goodrobotics/wifistepper/documentation/src/index.md

---
layout: default
title: Home
nav_order: 1
description: "Wi-Fi Stepper Project Documentation by Good Robotics"
---
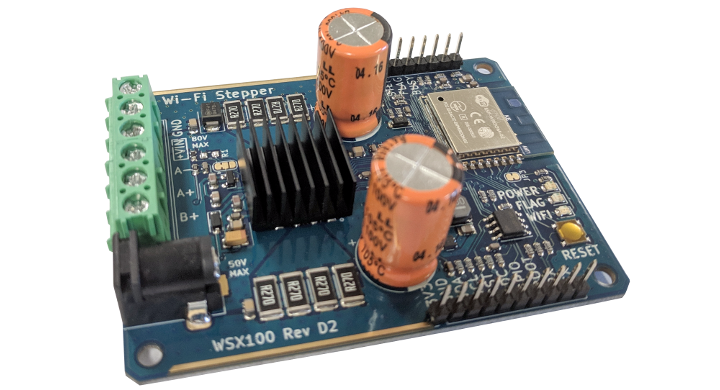
[picture p2: documentation/src/images/splash.png]

# Wi-Fi Stepper
{: .text-center .fs-9 .mb-1 }

## Project Documentation
{: .text-center .fs-7 .mb-6 .mt-1 }

An easy-to-use stepper motor controller accessible over wifi that can handle small to big stepper motors with input voltages ranging from 12V to 80V and output current up to 10A.
{: .fs-6 .fw-300 }

[Get started now](/getting-started.html){: .btn .btn-primary .fs-5 .mb-4 .mb-md-0 .mr-2 } [View it on GitHub](https://github.com/goodrobotics/wifistepper){: .btn .fs-5 .mb-4 .mb-md-0 }

---
