goodrobotics/wifistepper/documentation/src/interfaces/index.md

---
layout: default
title: Interfaces
nav_order: 8
has_children: true
---
# Interfaces

The following interfaces can be used to control the Wi-Fi Stepper programtically. To learn about the available commands, visit the [commands section](/commands/index.html).
