goodrobotics/wifistepper/hardware/wsx100/screenshot.png

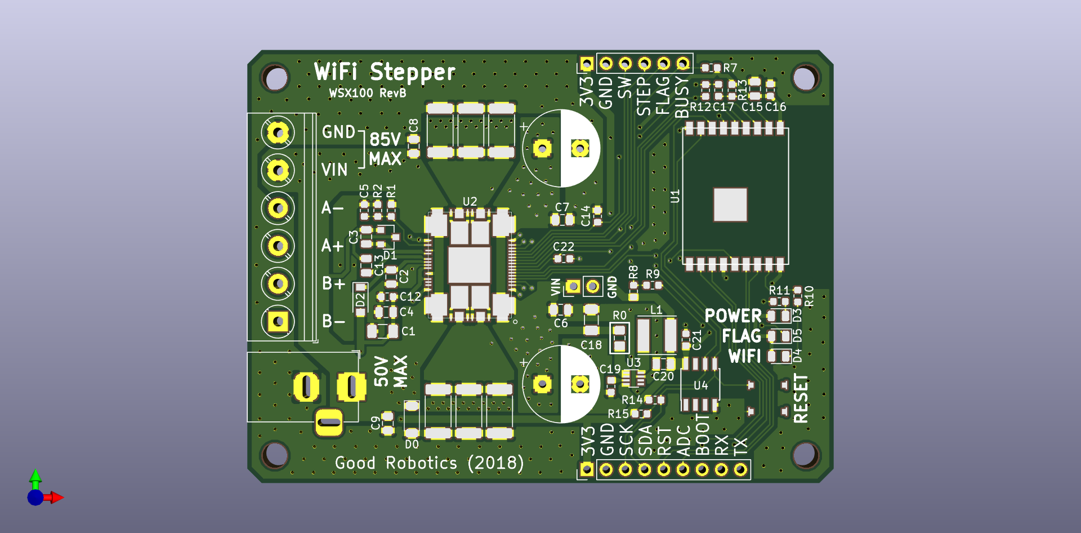
hardware/wsx100/screenshot.png
