goodrobotics/wifistepper/documentation/src/getting-started.md

---
layout: default
title: Getting Started
nav_order: 2
---
# Getting started with the Wi-Fi Stepper

The following tutorial video is a quick intrduction to get you started using the browser-based quick start guide.

<iframe width="560" height="315" src="https://www.youtube-nocookie.com/embed/1BNP5NVybpc" frameborder="0" allow="accelerometer; autoplay; encrypted-media; gyroscope; picture-in-picture" allowfullscreen></iframe>

# Settings Page Overview

An overview of the difference configuration settings of the Wi-Fi Stepper

<iframe width="560" height="315" src="https://www.youtube-nocookie.com/embed/98ZXk8F2e30" frameborder="0" allow="accelerometer; autoplay; encrypted-media; gyroscope; picture-in-picture" allowfullscreen></iframe>
