goodrobotics/wifistepper/hardware/powerstep01-breakout/powerstep01-breakout.pdf

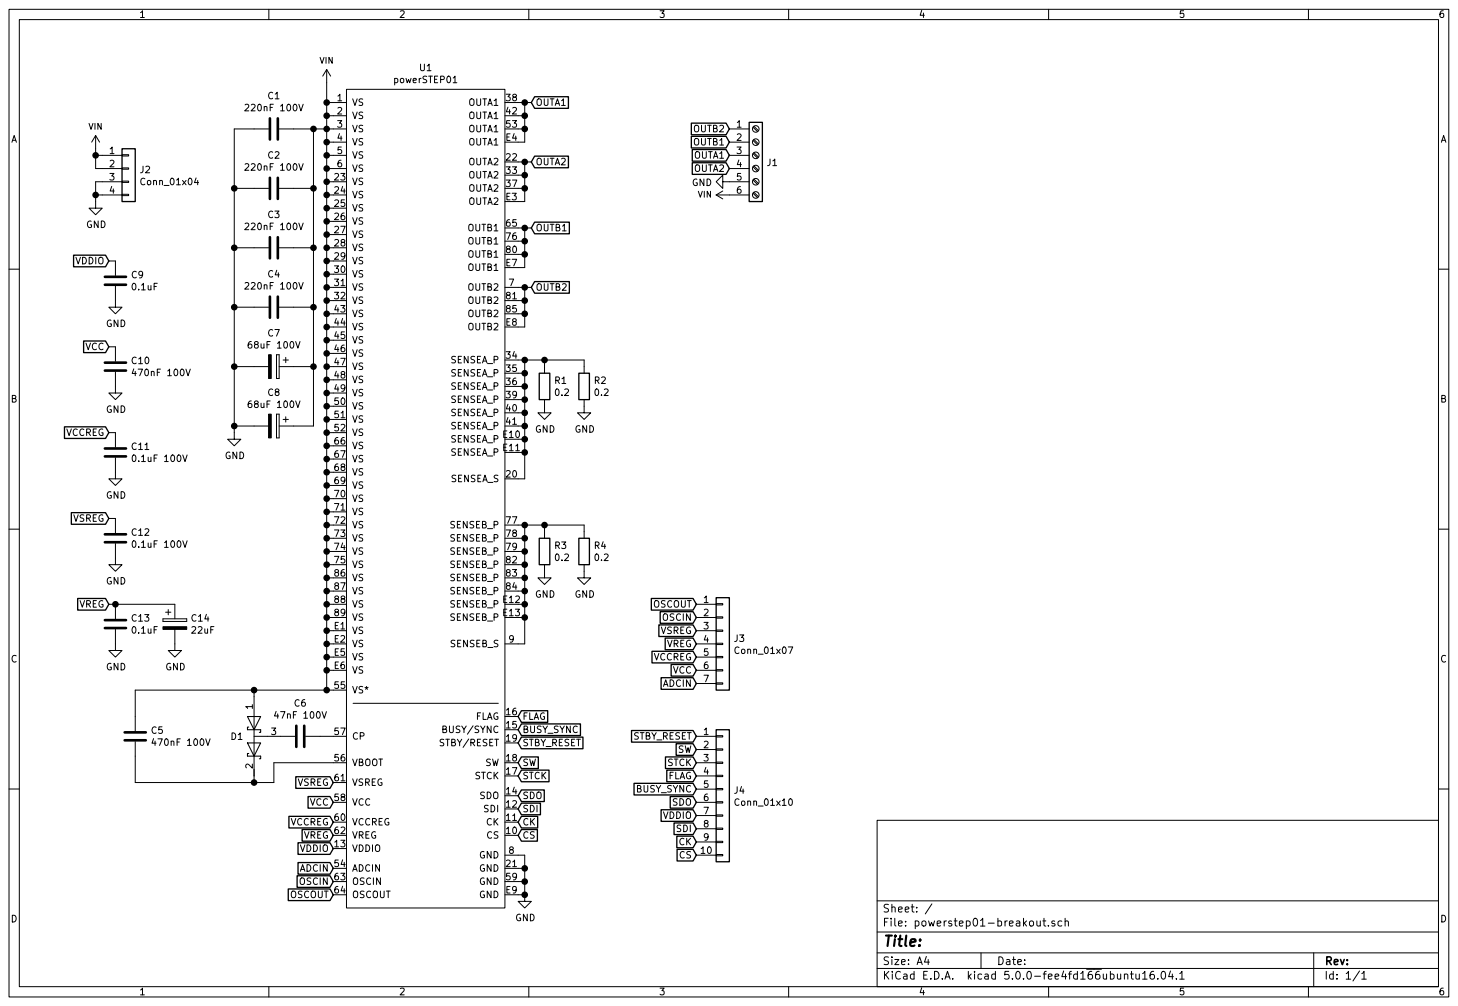
[picture p6: page 1]

File: powerstep01-breakout.sch Sheet: /
