goodrobotics/wifistepper/hardware/wsx100/wifistepper.pdf

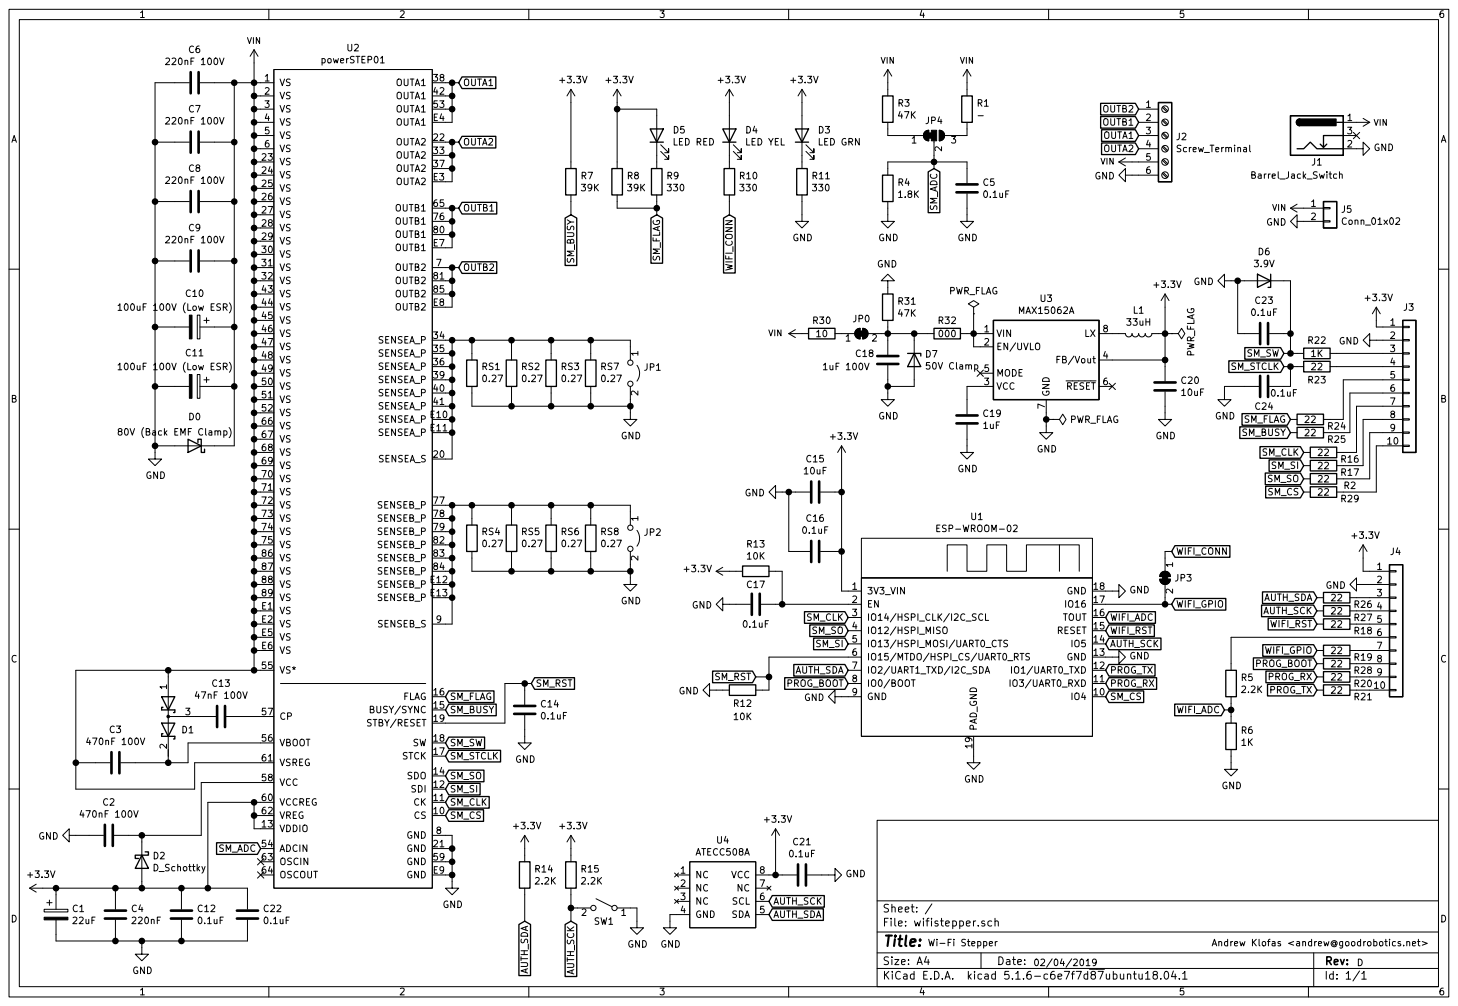
[picture p7: page 1]

File: wifistepper.sch Sheet: / RS5
