goodrobotics/wifistepper/hardware/wsx100/wifistepper.kicad_pcb

## KiCad design hardware/wsx100/wifistepper.kicad_pcb (2021-05-19)

Schematic: wifistepper.sch

Parts:
C1: 22uF; C_1206_3216Metric
C2, C3: 470nF 100V; C_0805_2012Metric
C4: 220nF; C_0805_2012Metric
C5, C12, C14, C16, C17, C21, C22, C23, C24: 0.1uF; C_0603_1608Metric
C6, C7, C8, C9: 220nF 100V; C_0805_2012Metric
C10, C11: 100uF 100V (Low ESR); CP_Radial_D12.5mm_P5.00mm
C13: 47nF 100V; C_0805_2012Metric
C15, C20: 10uF; C_0805_2012Metric
C18: 1uF 100V; C_0805_2012Metric
C19: 1uF; C_0603_1608Metric
D0: 80V (Back EMF Clamp); D_SMB
D1: D_Schottky_x2_Serial_AKC; SOT-23
D2: D_Schottky; D_SOD-123
D3: LED GRN; D_0805_2012Metric
D4: LED YEL; D_0805_2012Metric
D5: LED RED; D_0805_2012Metric
D6: 3.9V; D_SOD-123
D7: 50V Clamp; D_SMF_DO-219AB
FB1: Ferrite_Bead_Small; L_0603_1608Metric
J1: Barrel_Jack_Switch; BarrelJack_Horizontal
J2: Screw_Terminal; TerminalBlock_Phoenix_PT-1,5-6-5.0-H_1x06_P5.00mm_Horizontal
J3, J4: Conn_01x10; PinHeader_1x10_P2.54mm_Vertical
J5: Conn_01x02; PinHeader_1x02_P2.54mm_Vertical
JP0, JP3: SolderJumper_2_Bridged; SolderJumper-2_P1.3mm_Bridged_RoundedPad1.0x1.5mm
JP1, JP2: Jumper_2_Open; STpowerSTEP01_JMP
JP4: SolderJumper_3_Bridged12; SolderJumper-3_P1.3mm_Bridged12_RoundedPad1.0x1.5mm
L1: 33uH; L_Taiyo-Yuden_NR-50xx
R1: -; Resistor_NP_0805
R2, R16, R17, R18, R19, R20, R21, R23, R24, R25, R26, R27, R28, R29: 22; R_0603_1608Metric
R3: 47K; R_0603_1608Metric
R4: 1.8K; R_0603_1608Metric
R5, R14, R15: 2.2K; R_0603_1608Metric
R6, R22: 1K; R_0603_1608Metric
R7, R8: 39K; R_0603_1608Metric
R9, R10, R11: 330; R_0603_1608Metric
R12, R13: 10K; R_0603_1608Metric
RS1, RS2, RS3, RS4, RS5, RS6, RS7, RS8: 0.27; R_2512_6332Metric
SW1: SW_SPST; TL3315NF100Q
U1: ESP-WROOM-02
U2: powerSTEP01
U3: MAX15062A; DFN-8_2x2mm_P0.5mm
U4: ATECC508A; SOIC-8_3.9x4.9mm_P1.27mm

Connections:
+3V3: C1.1, C4.1, C12.1, C15.1, C16.1, C20.1, C21.2, C22.1, D2.2 (A), D3.2 (A), D4.2 (A), D5.2 (A), J3.1, J4.1, L1.1, R7.1, R8.1, R13.2, R14.1, R15.1, U1.1, U2.13, U2.60, U2.62, U3.4 (FB/Vout), U4.8
AUTH_SCK: R15.2, R27.2, SW1.2 (B), U1.14, U4.6
AUTH_SDA: R14.2, R26.2, U1.7, U4.5
GND: C1.2, C2.2, C4.2, C5.2, C6.2, C7.2, C8.2, C9.2, C10.2, C11.2, C12.2, C14.2, C15.2, C16.2, C17.2, C18.2, C19.2, C20.2, C21.1, C22.2, C23.2, C24.2, D0.2 (A), D6.2 (A), D7.2 (A), J1.2, J2.6, J3.2, J4.2, J5.2, JP1.2 (B), JP2.2 (B), R4.2, R6.2, R11.2, R12.2, RS1.1, RS2.1, RS3.1, RS4.1, RS5.1, RS6.1, RS7.1, RS8.1, SW1.1 (A), U1.9, U1.13, U1.18, U1.19, U2.8, U2.21, U2.59, U2.E9, U3.7 (GND), U4.4; also elsewhere on the board
unnamed: C2.1, D2.1 (K), U2.58
unnamed: C3.1, D1.2 (K), U2.56
unnamed: C13.1, U2.57
unnamed: C13.2, D1.3 (common)
unnamed: C17.1, R13.1, U1.2
unnamed: C19.1, U3.3 (VCC)
unnamed: D3.1 (K), R11.1
unnamed: D4.1 (K), R10.1
unnamed: D5.1 (K), R9.1
unnamed: J3.3, R22.1
unnamed: J3.4, R23.1
unnamed: J3.5, R24.1
unnamed: J3.6, R25.1
unnamed: J3.7, R16.1
unnamed: J3.8, R17.1
unnamed: J3.9, R2.1
unnamed: J3.10, R29.1
unnamed: J4.3, R26.1
unnamed: J4.4, R27.1
unnamed: J4.5, R18.1
unnamed: J4.6, R5.1
unnamed: J4.7, R19.1
unnamed: J4.8, R28.1
unnamed: J4.9, R20.1
unnamed: J4.10, R21.1
unnamed 30: JP0.1 (A); also elsewhere on the board
unnamed: JP1.1 (A), RS1.2, RS2.2, RS3.2, RS7.2, U2.20, U2.E10, U2.E11
unnamed: JP2.1 (A), RS4.2, RS5.2, RS6.2, RS8.2, U2.9, U2.E12, U2.E13
unnamed: JP4.1 (A), R3.2
unnamed: JP4.3 (B), R1.2
unnamed: L1.2, U3.8 (LX)
OUTA1: J2.3, U2.38, U2.42, U2.53, U2.E4
OUTA2: J2.4, U2.22, U2.33, U2.37, U2.E3
OUTB1: J2.2, U2.65, U2.76, U2.80, U2.E7
OUTB2: J2.1, U2.7, U2.81, U2.85, U2.E8
PROG_BOOT: R28.2, U1.8
PROG_RX: R20.2, U1.11
PROG_TX: R21.2, U1.12
SM_ADC: C5.1, JP4.2 (C), R4.1, U2.54
SM_BUSY: R7.2, R25.2, U2.15
SM_CLK: R16.2, U1.3, U2.11
SM_CS: R29.2, U1.10, U2.10
SM_FLAG: R8.2, R9.2, R24.2, U2.16
SM_RST: C14.1, R12.1, U1.6, U2.19
SM_SI: R17.2, U1.5, U2.12
SM_SO: R2.2, U1.4, U2.14
SM_STCLK: C24.1, R23.2, U2.17
SM_SW: C23.1, D6.1 (K), R22.2, U2.18
WIFI_ADC: R5.2, R6.1, U1.16
WIFI_CONN: JP3.1 (A), R10.2
WIFI_GPIO: JP3.2 (B), R19.2, U1.17
WIFI_RST: R18.2, U1.15

Notes on the sheet:
Wi-Fi Stepper
Andrew Klofas <andrew@goodrobotics.net>
02/04/2019

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
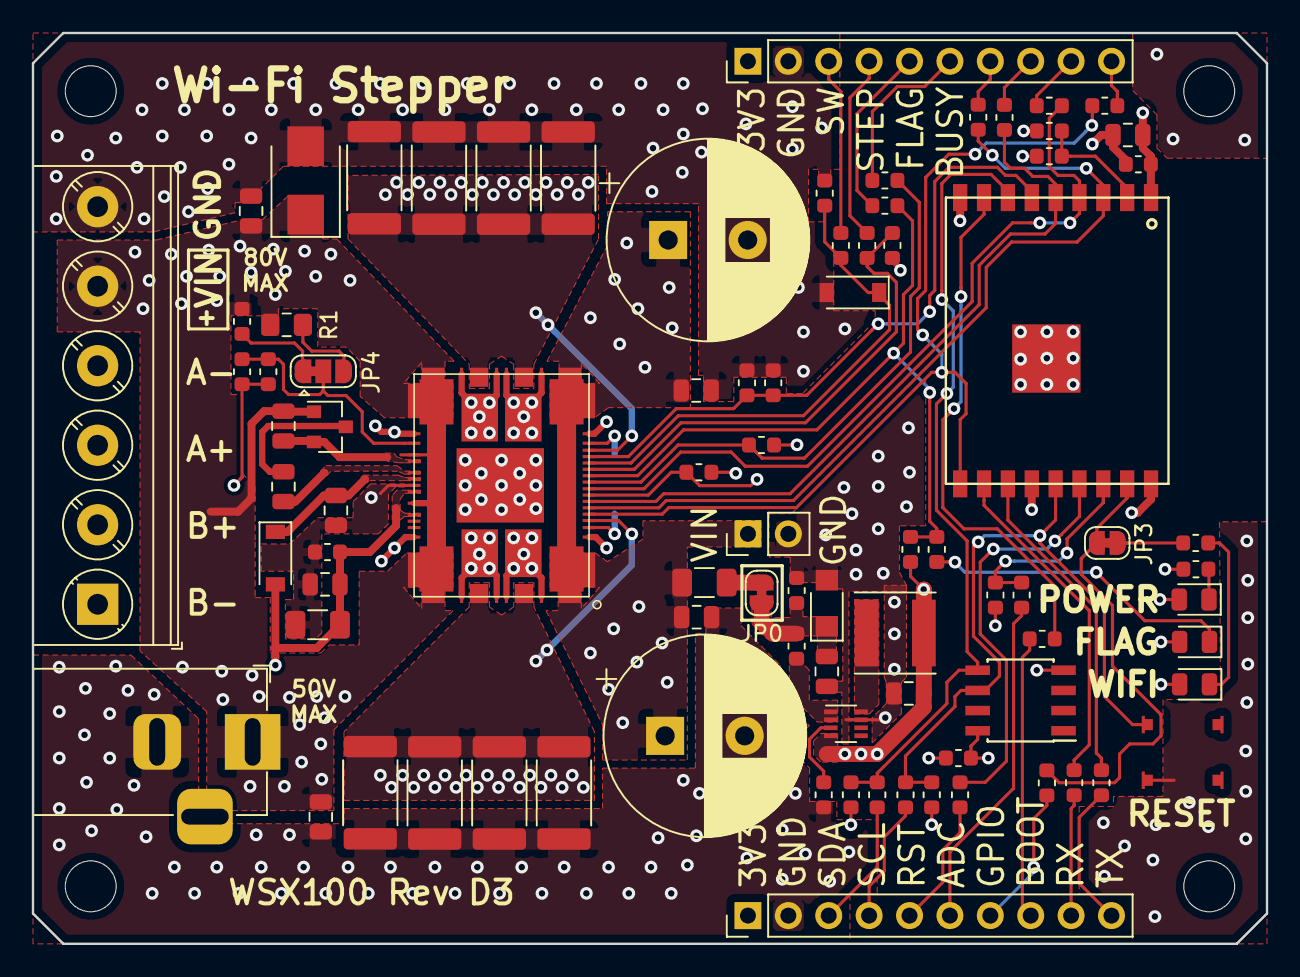
[picture p8: board wifistepper.kicad_pcb from above]

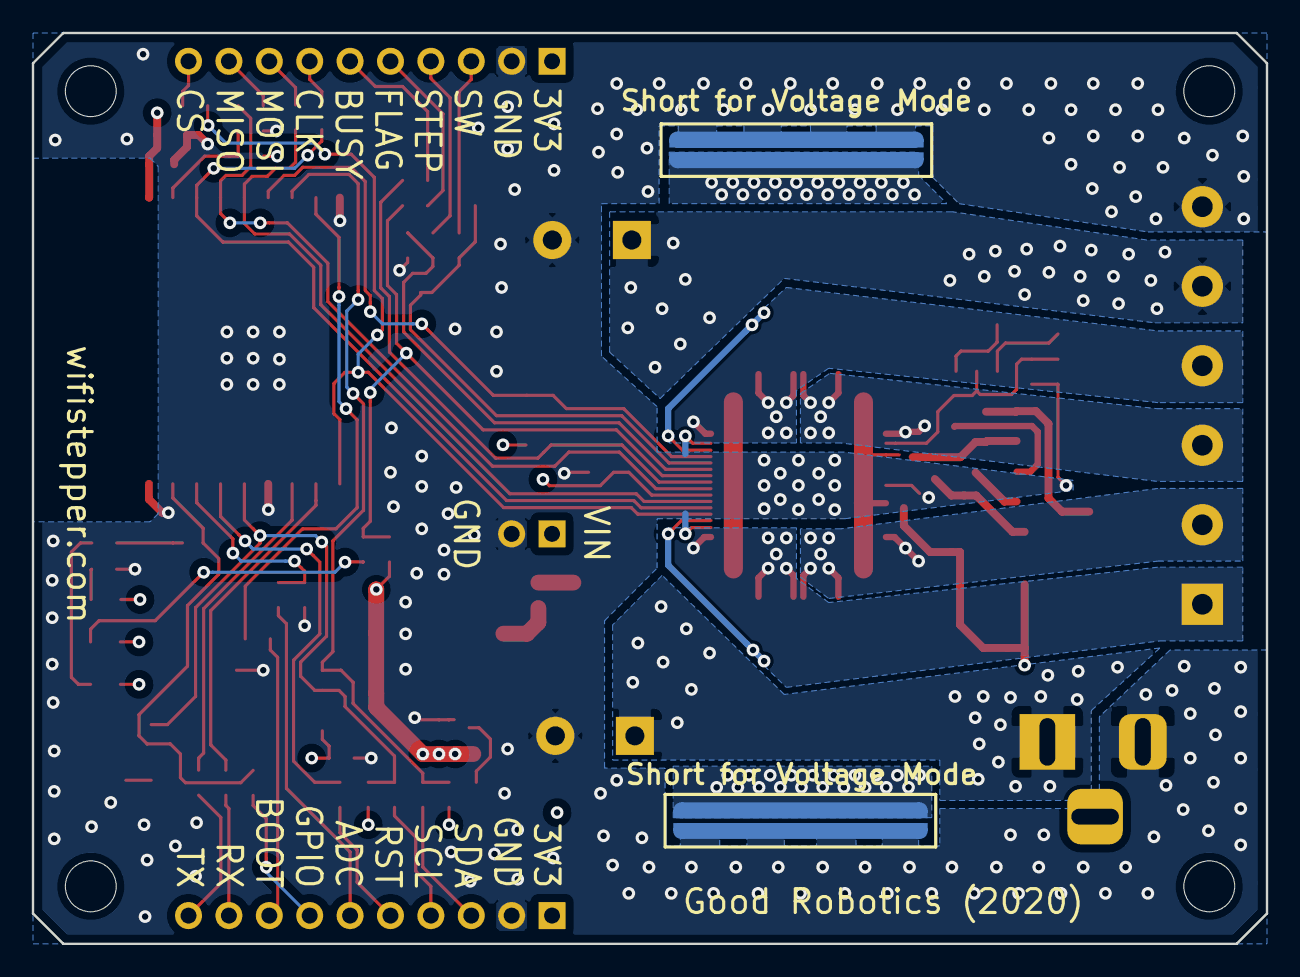
[picture p9: board wifistepper.kicad_pcb from below]

Board: 4 copper layers, 77.6 x 57.3 mm, 88 parts (2 on the bottom side), 59 nets.

Other parts of the board:
R30: 10; R_1206_3216Metric
R31: 47K; R_0603_1608Metric
R32: 000; R_0603_1608Metric

Their connections:
GND: R31.1; also elsewhere on the board
unnamed 30: R30.1; also elsewhere on the board
