goodrobotics/wifistepper/hardware/powerstep01-breakout/powerstep01-breakout.kicad_pcb

## KiCad design hardware/powerstep01-breakout/powerstep01-breakout.kicad_pcb (2019-07-09)

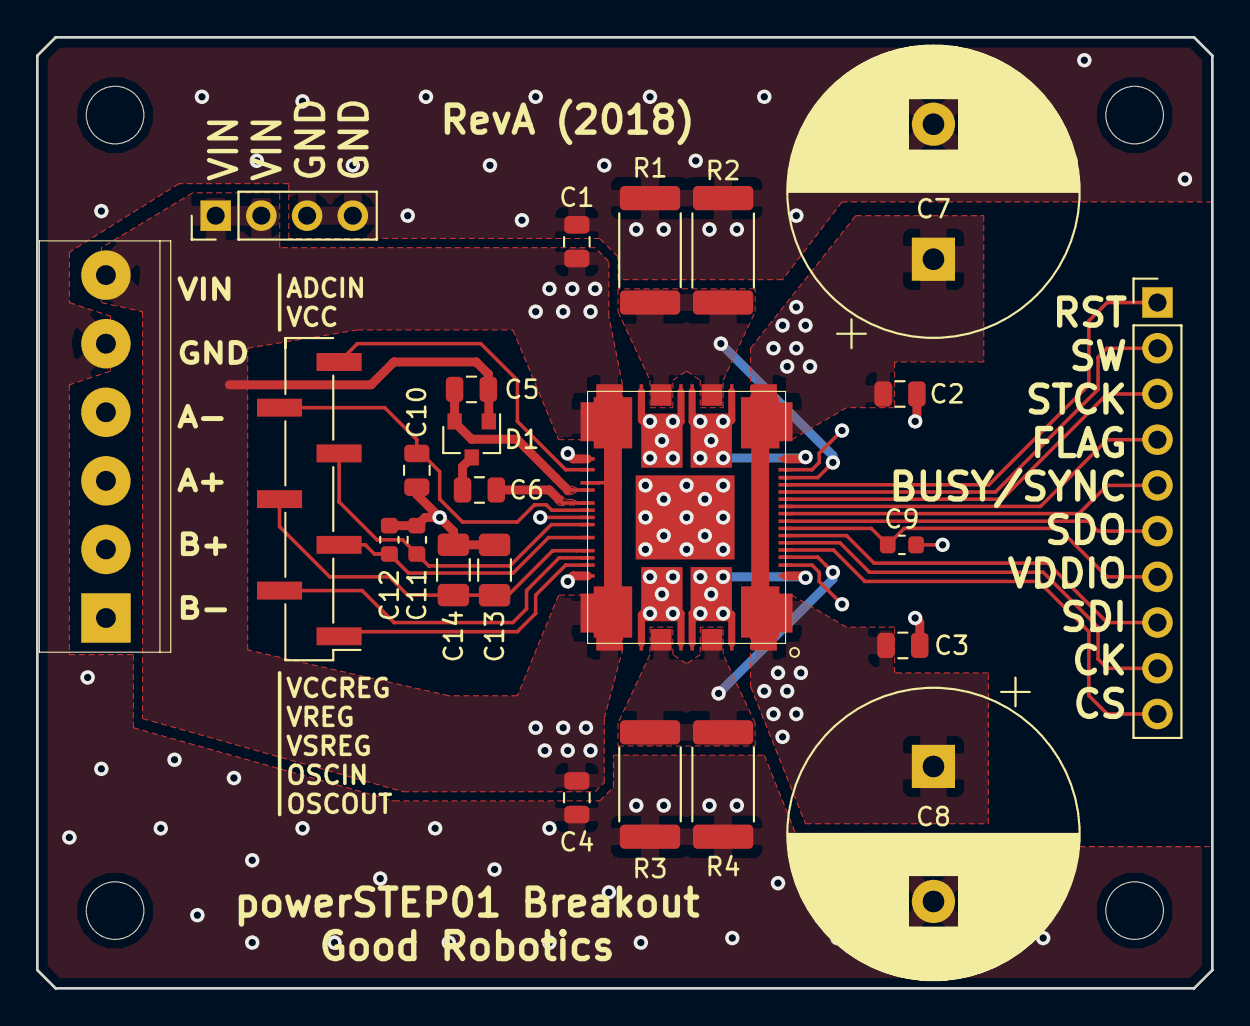
[picture p10: board powerstep01-breakout.kicad_pcb from above]

Board: 2 copper layers, 65.3 x 52.8 mm, 24 parts (0 on the bottom side), 28 nets.

Parts:
C1, C2, C3, C4: 220nF 100V; C_0805_2012Metric
C5, C10: 470nF 100V; C_0805_2012Metric
C6: 47nF 100V; C_0805_2012Metric
C7, C8: 68uF 100V; CP_Radial_D16.0mm_P7.50mm
C9: 0.1uF; C_0603_1608Metric
C11, C12: 0.1uF 100V; C_0603_1608Metric
C13: 0.1uF; C_1206_3216Metric
C14: 22uF; C_1206_3216Metric
D1: D_Schottky_x2_Serial_AKC; SOT-23
J1: Screw_Terminal_01x06; Phoenix_Screw_Terminal-MKDS_1,6-P3.81x06
J2: Conn_01x04; PinHeader_1x04_P2.54mm_Vertical
J3: Conn_01x07; PinHeader_1x07_P2.54mm_Vertical_SMD_Pin1Left
J4: Conn_01x10; PinHeader_1x10_P2.54mm_Vertical
R1, R2, R3, R4: 0.2; R_2512_6332Metric
U1: powerSTEP01

Connections:
ADCIN: J3.7, U1.54
BUSY_SYNC: J4.5, U1.15
CK: J4.9, U1.11
CS: J4.10, U1.10
FLAG: J4.4, U1.16
GND: C1.2, C2.2, C3.2, C4.2, C7.2, C8.2, C9.2, C10.2, C11.2, C12.2, C13.2, C14.2, J1.5, J2.3, J2.4, R1.2, R2.2, R3.2, R4.2, U1.8, U1.21, U1.59, U1.E9
unnamed: C5.2, D1.2, U1.56
unnamed: C6.1, U1.57
unnamed: C6.2, D1.3
unnamed: R1.1, R2.1, U1.20, U1.E10, U1.E11
unnamed: R3.1, R4.1, U1.9, U1.E12, U1.E13
OSCIN: J3.2, U1.63
OSCOUT: J3.1, U1.64
OUTA1: J1.3, U1.38, U1.42, U1.53, U1.E4
OUTA2: J1.4, U1.22, U1.33, U1.37, U1.E3
OUTB1: J1.2, U1.65, U1.76, U1.80, U1.E7
OUTB2: J1.1, U1.7, U1.81, U1.85, U1.E8
SDI: J4.8, U1.12
SDO: J4.6, U1.14
STBY_RESET: J4.1, U1.19
STCK: J4.3, U1.17
SW: J4.2, U1.18
VCC: C10.1, J3.6, U1.58
VCCREG: C11.1, J3.5, U1.60
VDDIO: C9.1, J4.7, U1.13
VIN: C1.1, C2.1, C3.1, C4.1, C5.1, C7.1, C8.1, D1.1, J1.6, J2.1, J2.2, U1.55, U1.E1, U1.E2, U1.E5, U1.E6
VREG: C13.1, C14.1, J3.4, U1.62
VSREG: C12.1, J3.3, U1.61
