goodrobotics/wifistepper/firmware/wifistepper/command.cpp

#include <Arduino.h>

#include "command.h"
#include "powerstep01.h"
#include "wifistepper.h"

//#define CMD_DEBUG

extern StaticJsonBuffer<2560> jsonbuf;

#define CTO_UPDATE      (10)

#define Q0_SIZE       (1024)
#define Q1_SIZE       (128)
#define Q2_SIZE       (32)

#define Q0_NUM        (1)
#define Q1_NUM        (5)
#define Q2_NUM        (QS_SIZE - Q0_NUM - Q1_NUM)

uint8_t __q0[Q0_NUM][Q0_SIZE];
uint8_t __q1[Q1_NUM][Q1_SIZE];
uint8_t __q2[Q2_NUM][Q2_SIZE];


#ifdef CMD_DEBUG
void cmd_debug(id_t id, uint8_t opcode, const char * msg) {
  Serial.print("Q(");
  Serial.print(id);
  Serial.print(", ");
  Serial.print(millis());
  Serial.print(") 0x");
  Serial.print(opcode, HEX);
  Serial.print(" -> ");
  Serial.println(msg);
}
#else
#define cmd_debug(...)
#endif

static void cmd_updatestatus(bool clearerrors) {
  state.motor.status = ps_getstatus(clearerrors);
  state.motor.status.direction = motorcfg_dir(state.motor.status.direction);
}

static void cmd_updatestate() {
  cmd_updatestatus(false);
  state.motor.stepss = ps_getspeed();
  state.motor.pos = motorcfg_pos(ps_getpos());
  state.motor.mark = motorcfg_pos(ps_getmark());
  state.motor.vin = (config.motor.mode != MODE_VOLTAGE || !config.motor.vm.volt_comp)? ((float)ps_readadc() * MOTOR_ADCCOEFF) : 0;
}

void cmd_init() {
  // Initialize queues
  size_t i = 0;
  for (size_t a = 0; a < Q0_NUM; a++) queue[i++] = { .len = 0, .maxlen = Q0_SIZE, .Q = __q0[a] };
  for (size_t a = 0; a < Q1_NUM; a++) queue[i++] = { .len = 0, .maxlen = Q1_SIZE, .Q = __q1[a] };
  for (size_t a = 0; a < Q2_NUM; a++) queue[i++] = { .len = 0, .maxlen = Q2_SIZE, .Q = __q2[a] };
}

void cmd_loop(unsigned long now) {
  state.command.this_command = 0;
  ESP.wdtFeed();

  while (Q0->len > 0) {
    cmd_head_t * head = (cmd_head_t *)(Q0->Q);
    void * Qcmd = (void *)&(Q0->Q[sizeof(cmd_head_t)]);
    
    state.command.this_command = head->id;
    size_t consume = sizeof(cmd_head_t);

    cmd_debug(head->id, head->opcode, "Try exec");

    // Check pre-conditions
    if (head->opcode & (QPRE_STATUS | QPRE_NOTBUSY | QPRE_STOPPED)) {
      sketch.motor.last.status = now;
      cmd_updatestatus(false);

      if ((head->opcode & QPRE_NOTBUSY) && state.motor.status.busy) return;
      if ((head->opcode & QPRE_STOPPED) && state.motor.status.movement != M_STOPPED) return;
    }
      
    switch (head->opcode) {
      //case CMD_NOP:
      case CMD_WAITBUSY:
      case CMD_WAITRUNNING: {
        // Do nothing
        //ps_nop();
        break;
      }
      case CMD_STOP: {
        cmd_stop_t * cmd = (cmd_stop_t *)Qcmd;
        if (cmd->hiz) {
          if (cmd->soft)  ps_softhiz();
          else            ps_hardhiz();
        } else {
          if (cmd->soft)  ps_softstop();
          else            ps_hardstop();
        }
        consume += sizeof(cmd_stop_t);
        break;
      }
      case CMD_RUN: {
        cmd_run_t * cmd = (cmd_run_t *)Qcmd;
        ps_run(motorcfg_dir(cmd->dir), cmd->stepss);
        consume += sizeof(cmd_run_t);
        break;
      }
      case CMD_STEPCLK: {
        cmd_stepclk_t * cmd = (cmd_stepclk_t *)Qcmd;
        ps_stepclock(motorcfg_dir(cmd->dir));
        consume += sizeof(cmd_stepclk_t);
        break;
      }
      case CMD_MOVE: {
        cmd_move_t * cmd = (cmd_move_t *)Qcmd;
        ps_move(motorcfg_dir(cmd->dir), cmd->microsteps);
        consume += sizeof(cmd_move_t);
        break;
      }
      case CMD_GOTO: {
        cmd_goto_t * cmd = (cmd_goto_t *)Qcmd;
        if (cmd->hasdir)  ps_goto(motorcfg_pos(cmd->pos), motorcfg_dir(cmd->dir));
        else              ps_goto(motorcfg_pos(cmd->pos));
        consume += sizeof(cmd_goto_t);
        break;
      }
      case CMD_GOUNTIL: {
        cmd_gountil_t * cmd = (cmd_gountil_t *)Qcmd;
        ps_gountil(cmd->action, motorcfg_dir(cmd->dir), cmd->stepss);
        consume += sizeof(cmd_gountil_t);
        break;
      }
      case CMD_RELEASESW: {
        cmd_releasesw_t * cmd = (cmd_releasesw_t *)Qcmd;
        ps_releasesw(cmd->action, motorcfg_dir(cmd->dir));
        consume += sizeof(cmd_releasesw_t);
        break;
      }
      case CMD_GOHOME: {
        ps_gohome();
        break;
      }
      case CMD_GOMARK: {
        ps_gomark();
        break;
      }
      case CMD_RESETPOS: {
        ps_resetpos();
        break;
      }
      case CMD_SETPOS: {
        cmd_setpos_t * cmd = (cmd_setpos_t *)Qcmd;
        ps_setpos(cmd->pos);
        consume += sizeof(cmd_setpos_t);
        break;
      }
      case CMD_SETMARK: {
        cmd_setpos_t * cmd = (cmd_setpos_t *)Qcmd;
        ps_setmark(cmd->pos);
        consume += sizeof(cmd_setpos_t);
        break;
      }
      case CMD_SETCONFIG: {
        const char * data = (const char *)Qcmd;
        size_t ldata = strlen(data);
        bool save = false;
        if (ldata > 0) {
          cmd_debug(head->id, head->opcode, data);
          JsonObject& root = jsonbuf.parseObject(data);
          if (root.containsKey("mode"))       config.motor.mode = parse_motormode(root["mode"], config.motor.mode);
          if (root.containsKey("stepsize"))   config.motor.stepsize = parse_stepsize(root["stepsize"].as<int>(), config.motor.stepsize);
          if (root.containsKey("ocd"))        config.motor.ocd = root["ocd"].as<float>();
          if (root.containsKey("ocdshutdown")) config.motor.ocdshutdown = root["ocdshutdown"].as<bool>();
          if (root.containsKey("maxspeed"))   config.motor.maxspeed = root["maxspeed"].as<float>();
          if (root.containsKey("minspeed"))   config.motor.minspeed = root["minspeed"].as<float>();
          if (root.containsKey("accel"))      config.motor.accel = root["accel"].as<float>();
          if (root.containsKey("decel"))      config.motor.decel = root["decel"].as<float>();
          if (root.containsKey("fsspeed"))    config.motor.fsspeed = root["fsspeed"].as<float>();
          if (root.containsKey("fsboost"))    config.motor.fsboost = root["fsboost"].as<bool>();
          if (root.containsKey("cm_kthold"))  config.motor.cm.kthold = root["cm_kthold"].as<float>();
          if (root.containsKey("cm_ktrun"))   config.motor.cm.ktrun = root["cm_ktrun"].as<float>();
          if (root.containsKey("cm_ktaccel")) config.motor.cm.ktaccel = root["cm_ktaccel"].as<float>();
          if (root.containsKey("cm_ktdecel")) config.motor.cm.ktdecel = root["cm_ktdecel"].as<float>();
          if (root.containsKey("cm_switchperiod")) config.motor.cm.switchperiod = root["cm_switchperiod"].as<float>();
          if (root.containsKey("cm_predict")) config.motor.cm.predict = root["cm_predict"].as<bool>();
          if (root.containsKey("cm_minon"))   config.motor.cm.minon = root["cm_minon"].as<float>();
          if (root.containsKey("cm_minoff"))  config.motor.cm.minoff = root["cm_minoff"].as<float>();
          if (root.containsKey("cm_fastoff")) config.motor.cm.fastoff = root["cm_fastoff"].as<float>();
          if (root.containsKey("cm_faststep")) config.motor.cm.faststep = root["cm_faststep"].as<float>();
          if (root.containsKey("vm_kthold"))  config.motor.vm.kthold = root["vm_kthold"].as<float>();
          if (root.containsKey("vm_ktrun"))   config.motor.vm.ktrun = root["vm_ktrun"].as<float>();
          if (root.containsKey("vm_ktaccel")) config.motor.vm.ktaccel = root["vm_ktaccel"].as<float>();
          if (root.containsKey("vm_ktdecel")) config.motor.vm.ktdecel = root["vm_ktdecel"].as<float>();
          if (root.containsKey("vm_pwmfreq")) config.motor.vm.pwmfreq = root["vm_pwmfreq"].as<float>();
          if (root.containsKey("vm_stall"))   config.motor.vm.stall = root["vm_stall"].as<float>();
          if (root.containsKey("vm_volt_comp")) config.motor.vm.volt_comp = root["vm_volt_comp"].as<bool>();
          if (root.containsKey("vm_bemf_slopel")) config.motor.vm.bemf_slopel = root["vm_bemf_slopel"].as<float>();
          if (root.containsKey("vm_bemf_speedco")) config.motor.vm.bemf_speedco = root["vm_bemf_speedco"].as<float>();
          if (root.containsKey("vm_bemf_slopehacc")) config.motor.vm.bemf_slopehacc = root["vm_bemf_slopehacc"].as<float>();
          if (root.containsKey("vm_bemf_slopehdec")) config.motor.vm.bemf_slopehdec = root["vm_bemf_slopehdec"].as<float>();
          if (root.containsKey("reverse"))    config.motor.reverse = root["reverse"].as<bool>();
          save = root.containsKey("save") && root["save"].as<bool>();
          jsonbuf.clear();
        }
        motorcfg_push(&config.motor);
        if (save) motorcfg_write(&config.motor);
        consume += ldata + 1;
        break;
      }
      case CMD_WAITMS: {
        sketch_waitms_t * sketch = (sketch_waitms_t *)Qcmd;
        if (sketch->started == 0) sketch->started = millis();
        if (timesince(sketch->started, millis()) < sketch->ms) return;
        consume += sizeof(sketch_waitms_t);
        break;
      }
      case CMD_WAITSWITCH: {
        cmd_waitsw_t * cmd = (cmd_waitsw_t *)Qcmd;
        if (cmd->state != state.motor.status.user_switch) return;
        consume += sizeof(cmd_waitsw_t);
        break;
      }
      case CMD_STOPSWITCH: {
        cmd_stopsw_t * cmd = (cmd_stopsw_t *)Qcmd;
        if (!state.motor.status.busy) {
          // Break if not busy
          consume += sizeof(cmd_waitsw_t);
          break;
        }
        
        if (cmd->state != state.motor.status.user_switch) {
          // Switch not pressed, return
          return;
        }

        // Switch pressed, issue stop
        ps_softhiz();
        consume += sizeof(cmd_waitsw_t);
        break;
      }
      case CMD_RUNQUEUE: {
        cmd_runqueue_t * cmd = (cmd_runqueue_t *)Qcmd;
        consume += sizeof(cmd_runqueue_t);
        queue_t * target = queue_get(cmd->targetqueue);
        if (cmd->targetqueue == 0 || target == NULL) {
          // Bad target queue
          seterror(ESUB_CMD, head->id, ETYPE_NOQUEUE);
          break;
        }
        if ((Q0->len - consume + target->len) > Q0->maxlen) {
          // Not enough memory in queue
          seterror(ESUB_CMD, head->id, ETYPE_MEM);
          break;
        }
        memmove(&Q0->Q[target->len], &Q0->Q[consume], Q0->len - consume);
        memcpy(Q0->Q, target->Q, target->len);
        Q0->len += target->len - consume;
        consume = 0;
        break;
      }
      case CMD_SETSIGNAL: {
        cmd_signal_t * cmd = (cmd_signal_t *)Qcmd;
        state.signal.value = cmd->value;
        state.signal.modified = millis();
        consume += sizeof(cmd_signal_t);
        break;
      }
      case CMD_INCSIGNAL: {
        cmd_signal_t * cmd = (cmd_signal_t *)Qcmd;
        state.signal.value += cmd->value;
        state.signal.modified = millis();
        consume += sizeof(cmd_signal_t);
        break;
      }
      case CMD_TRIGQUEUE: {
        cmd_trigqueue_t * cmd = (cmd_trigqueue_t *)Qcmd;
        m_runqueue(cmd->target, 0, nextid(), cmd->targetqueue);
        consume += sizeof(cmd_trigqueue_t);
        break;
      }
    }

    if (consume > 0) {
      memmove(Q0->Q, &Q0->Q[consume], Q0->len - consume);
      Q0->len -= consume;
    }
    state.command.last_command = head->id;
    state.command.last_completed = millis();

    cmd_debug(head->id, head->opcode, "Exec complete");
    ESP.wdtFeed();
  }
}

void cmd_update(unsigned long now) {
  if (timesince(sketch.motor.last.status, now) > CTO_UPDATE) {
    sketch.motor.last.status = now;
    cmd_updatestatus(false);
    
    bool iserror = state.motor.status.alarms.command_error || state.motor.status.alarms.overcurrent || state.motor.status.alarms.undervoltage || state.motor.status.alarms.thermal_shutdown;
    if (iserror) {
      seterror(ESUB_MOTOR);
    }
  }
  
  if (timesince(sketch.motor.last.state, now) > CTO_UPDATE) {
    sketch.motor.last.state = now;
    cmd_updatestate();
  }
}

static void * cmd_alloc(queue_t * queue, id_t id, size_t len) {
  if (queue == NULL) {
    seterror(ESUB_CMD, id, ETYPE_NOQUEUE);
    return NULL;
  }
  if ((queue->maxlen - queue->len) < len) {
    seterror(ESUB_CMD, id, ETYPE_MEM);
    return NULL;
  }
  void * p = &queue->Q[queue->len];
  queue->len += len;
  return p;
}

static void * cmd_alloc(queue_t * queue, id_t id, uint8_t opcode, size_t len) {
  cmd_head_t * cmd = (cmd_head_t *)cmd_alloc(queue, id, sizeof(cmd_head_t) + len);
  if (cmd == NULL) return NULL;
  *cmd = { .id = id, .opcode = opcode };
  return &cmd[1];
}

/*bool cmd_nop(queue_t * queue, id_t id) {
  return cmd_alloc(queue, id, CMD_NOP, 0) != NULL;
}*/

bool cmd_stop(queue_t * queue, id_t id, bool hiz, bool soft) {
  cmd_stop_t * cmd = (cmd_stop_t *)cmd_alloc(queue, id, CMD_STOP, sizeof(cmd_stop_t));
  if (cmd != NULL) *cmd = { .hiz = hiz, .soft = soft };
  return cmd != NULL;
}

bool cmd_run(queue_t * queue, id_t id, ps_direction dir, float stepss) {
  cmd_run_t * cmd = (cmd_run_t *)cmd_alloc(queue, id, CMD_RUN, sizeof(cmd_run_t));
  if (cmd != NULL) *cmd = { .dir = dir, .stepss = stepss };
  return cmd != NULL;
}

bool cmd_stepclock(queue_t * queue, id_t id, ps_direction dir) {
  cmd_stepclk_t * cmd = (cmd_stepclk_t *)cmd_alloc(queue, id, CMD_STEPCLK, sizeof(cmd_stepclk_t));
  if (cmd != NULL) *cmd = { .dir = dir };
  return cmd != NULL;
}

bool cmd_move(queue_t * queue, id_t id, ps_direction dir, uint32_t microsteps) {
  cmd_move_t * cmd = (cmd_move_t *)cmd_alloc(queue, id, CMD_MOVE, sizeof(cmd_move_t));
  if (cmd != NULL) *cmd = { .dir = dir, .microsteps = microsteps };
  return cmd != NULL;
}

bool cmd_goto(queue_t * queue, id_t id, int32_t pos, bool hasdir, ps_direction dir) {
  cmd_goto_t * cmd = (cmd_goto_t *)cmd_alloc(queue, id, CMD_GOTO, sizeof(cmd_goto_t));
  if (cmd != NULL) *cmd = { .hasdir = hasdir, .dir = dir, .pos = pos };
  return cmd != NULL;
}

bool cmd_gountil(queue_t * queue, id_t id, ps_posact action, ps_direction dir, float stepss) {
  cmd_gountil_t * cmd = (cmd_gountil_t *)cmd_alloc(queue, id, CMD_GOUNTIL, sizeof(cmd_gountil_t));
  if (cmd != NULL) *cmd = { .action = action, .dir = dir, .stepss = stepss };
  return cmd != NULL;
}

bool cmd_releasesw(queue_t * queue, id_t id, ps_posact action, ps_direction dir) {
  cmd_releasesw_t * cmd = (cmd_releasesw_t *)cmd_alloc(queue, id, CMD_RELEASESW, sizeof(cmd_releasesw_t));
  if (cmd != NULL) *cmd = { .action = action, .dir = dir };
  return cmd != NULL;
}

bool cmd_gohome(queue_t * queue, id_t id) {
  return cmd_alloc(queue, id, CMD_GOHOME, 0) != NULL;
}

bool cmd_gomark(queue_t * queue, id_t id) {
  return cmd_alloc(queue, id, CMD_GOMARK, 0) != NULL;
}

bool cmd_resetpos(queue_t * queue, id_t id) {
  return cmd_alloc(queue, id, CMD_RESETPOS, 0) != NULL;
}

bool cmd_setpos(queue_t * queue, id_t id, int32_t pos) {
  cmd_setpos_t * cmd = (cmd_setpos_t *)cmd_alloc(queue, id, CMD_SETPOS, sizeof(cmd_setpos_t));
  if (cmd != NULL) *cmd = { .pos = pos };
  return cmd != NULL;
}

bool cmd_setmark(queue_t * queue, id_t id, int32_t mark) {
  cmd_setpos_t * cmd = (cmd_setpos_t *)cmd_alloc(queue, id, CMD_SETMARK, sizeof(cmd_setpos_t));
  if (cmd != NULL) *cmd = { .pos = mark };
  return cmd != NULL;
}

bool cmd_setconfig(queue_t * queue, id_t id, const char * data) {
  size_t ldata = strlen(data) + 1;
  void * buf = cmd_alloc(queue, id, CMD_SETCONFIG, ldata);
  if (buf != NULL) memcpy(buf, data, ldata);
  return buf != NULL;
}

bool cmd_waitbusy(queue_t * queue, id_t id) {
  return cmd_alloc(queue, id, CMD_WAITBUSY, 0) != NULL;
}

bool cmd_waitrunning(queue_t * queue, id_t id) {
  return cmd_alloc(queue, id, CMD_WAITRUNNING, 0) != NULL;
}

bool cmd_waitms(queue_t * queue, id_t id, uint32_t ms) {
  sketch_waitms_t * cmd = (sketch_waitms_t *)cmd_alloc(queue, id, CMD_WAITMS, sizeof(sketch_waitms_t));
  if (cmd != NULL) *cmd = { .ms = ms, .started = 0 };
  return cmd != NULL;
}

bool cmd_waitswitch(queue_t * queue, id_t id, bool state) {
  cmd_waitsw_t * cmd = (cmd_waitsw_t *)cmd_alloc(queue, id, CMD_WAITSWITCH, sizeof(cmd_waitsw_t));
  if (cmd != NULL) *cmd = { .state = state };
  return cmd != NULL;
}

bool cmd_runqueue(queue_t * queue, id_t id, uint8_t targetqueue) {
  cmd_runqueue_t * cmd = (cmd_runqueue_t *)cmd_alloc(queue, id, CMD_RUNQUEUE, sizeof(cmd_runqueue_t));
  if (cmd != NULL) *cmd = { .targetqueue = targetqueue };
  return cmd != NULL;
}

bool cmd_trigqueue(queue_t * queue, id_t id, uint8_t target, uint8_t targetqueue) {
  cmd_trigqueue_t * cmd = (cmd_trigqueue_t *)cmd_alloc(queue, id, CMD_TRIGQUEUE, sizeof(cmd_trigqueue_t));
  if (cmd != NULL) *cmd = { .target = target, .targetqueue = targetqueue };
  return cmd != NULL;
}

bool cmd_stopswitch(queue_t * queue, id_t id, bool state) {
  cmd_stopsw_t * cmd = (cmd_stopsw_t *)cmd_alloc(queue, id, CMD_STOPSWITCH, sizeof(cmd_stopsw_t));
  if (cmd != NULL) *cmd = { .state = state };
  return cmd != NULL;
}

bool cmd_setsignal(queue_t * queue, id_t id, int value) {
  cmd_signal_t * cmd = (cmd_signal_t *)cmd_alloc(queue, id, CMD_SETSIGNAL, sizeof(cmd_signal_t));
  if (cmd != NULL) *cmd = { .value = value };
  return cmd != NULL;
}

bool cmd_incsignal(queue_t * queue, id_t id, int value) {
  cmd_signal_t * cmd = (cmd_signal_t *)cmd_alloc(queue, id, CMD_INCSIGNAL, sizeof(cmd_signal_t));
  if (cmd != NULL) *cmd = { .value = value };
  return cmd != NULL;
}

bool cmd_estop(id_t id, bool hiz, bool soft) {
  if (hiz) {
    if (soft)   ps_softhiz();
    else        ps_hardhiz();
  } else {
    if (soft)   ps_softstop();
    else        ps_hardstop();
  }
  return cmdq_empty(Q0, id);
}

void cmd_clearerror() {
  cmd_updatestatus(true);
}

bool cmdq_copy(queue_t * queue, id_t id, queue_t * src) {
  if (src == NULL) {
    seterror(ESUB_CMD, id, ETYPE_NOQUEUE);
    return false;
  }
  void * buf = cmd_alloc(queue, id, src->len);
  if (buf == NULL) return false;
  memcpy(buf, src->Q, src->len);
  return true;
}
