goodrobotics/wifistepper/firmware/wifistepper/server.cpp

#include <ESP8266WebServer.h>
#include <FS.h>

#include "wifistepper.h"
#include "ecc508a.h"

extern ESP8266WebServer server;
extern StaticJsonBuffer<2560> jsonbuf;

extern volatile bool flag_reboot;

#define json_ok()         "{\"status\":\"ok\"}"
#define json_error(msg)   "{\"status\":\"error\",\"message\":\"" msg "\"}"

#define get_target() \
  int target = 0; \
  if (server.hasArg("target")) { \
    target = server.arg("target").toInt(); \
    if (target != 0 && (!config.daisy.enabled || !config.daisy.master || !state.daisy.active)) { \
      server.send(200, "application/json", json_error("failed to set target")); \
      return; \
    } \
    if (target < 0 || target > state.daisy.slaves) { \
      server.send(200, "application/json", json_error("invalid target")); \
      return; \
    } \
  }

#define get_queue() \
  int queue = 0; \
  if (server.hasArg("queue")) { \
    queue = server.arg("queue").toInt(); \
    if (queue < 0 || queue >= QS_SIZE) { \
      server.send(200, "application/json", json_error("invalid queue")); \
      return; \
    } \
  }

static String json_okid(id_t id) {
  return String("{\"status\":\"ok\",\"id\":") + id + "}";
}


void api_initwifi() {
  server.on("/api/wifi/scan", HTTP_GET, [](){
    add_headers()
    check_auth()
    int n = WiFi.scanNetworks();
    JsonObject& root = jsonbuf.createObject();
    JsonArray& networks = root.createNestedArray("networks");
    for (int i = 0; i < n; ++i) {
      JsonObject& network = jsonbuf.createObject();
      network["ssid"] = WiFi.SSID(i);
      network["rssi"] = WiFi.RSSI(i);
      network["encryption"] = WiFi.encryptionType(i) != ENC_TYPE_NONE;
      networks.add(network);
    }
    root["status"] = "ok";
    JsonVariant v = root;
    server.send(200, "application/json", v.as<String>());
    jsonbuf.clear();
  });
  server.on("/api/wifi/get", HTTP_GET, [](){
    add_headers()
    check_auth()
    JsonObject& root = jsonbuf.createObject();
    root["ip"] = IPAddress(state.wifi.ip).toString();
    root["rssi"] = state.wifi.rssi;
    root["mode"] = json_serialize(config.wifi.mode);
    root["accesspoint_ssid"] = config.wifi.accesspoint.ssid;
    root["accesspoint_password"] = config.wifi.accesspoint.encryption? config.wifi.accesspoint.password : "";
    root["accesspoint_encryption"] = config.wifi.accesspoint.encryption;
    root["accesspoint_channel"] = config.wifi.accesspoint.channel;
    root["accesspoint_hidden"] = config.wifi.accesspoint.hidden;
    root["station_ssid"] = config.wifi.station.ssid;
    root["station_password"] = config.wifi.station.encryption? config.wifi.station.password : "";
    root["station_encryption"] = config.wifi.station.encryption;
    root["station_forceip"] = config.wifi.station.forceip;
    root["station_forcesubnet"] = config.wifi.station.forcesubnet;
    root["station_forcegateway"] = config.wifi.station.forcegateway;
    root["station_revertap"] = config.wifi.station.revertap;
    root["status"] = "ok";
    JsonVariant v = root;
    server.send(200, "application/json", v.as<String>());
    jsonbuf.clear();
  });
  server.on("/api/wifi/set/off", HTTP_GET, [](){
    add_headers()
    check_auth()
    config.wifi.mode = M_OFF;
    wificfg_write(&config.wifi);
    flag_reboot = true;
    server.send(200, "application/json", json_ok());
  });
  server.on("/api/wifi/set/accesspoint", HTTP_GET, [](){
    add_headers()
    check_auth()
    config.wifi.mode = M_ACCESSPOINT;
    if (server.hasArg("ssid"))      strlcpy(config.wifi.accesspoint.ssid, server.arg("ssid").c_str(), LEN_SSID);
    if (server.hasArg("password"))  strlcpy(config.wifi.accesspoint.password, server.arg("password").c_str(), LEN_PASSWORD);
    if (server.hasArg("ssid"))      config.wifi.accesspoint.encryption = server.hasArg("password") && server.arg("password").length() > 0;
    if (server.hasArg("channel"))   config.wifi.accesspoint.channel = parse_channel(server.arg("channel"), config.wifi.accesspoint.channel);
    if (server.hasArg("hidden"))    config.wifi.accesspoint.hidden = server.arg("hidden") == "true";
    wificfg_write(&config.wifi);
    flag_reboot = true;
    server.send(200, "application/json", json_ok());
  });
  server.on("/api/wifi/set/station", HTTP_GET, [](){
    add_headers()
    check_auth()
    config.wifi.mode = M_STATION;
    if (server.hasArg("ssid"))      strlcpy(config.wifi.station.ssid, server.arg("ssid").c_str(), LEN_SSID);
    if (server.hasArg("password"))  strlcpy(config.wifi.station.password, server.arg("password").c_str(), LEN_PASSWORD);
    if (server.hasArg("ssid"))      config.wifi.station.encryption = server.hasArg("password") && server.arg("password").length() > 0;
    if (server.hasArg("forceip"))   strlcpy(config.wifi.station.forceip, server.arg("forceip").c_str(), LEN_IP);
    if (server.hasArg("forcesubnet")) strlcpy(config.wifi.station.forcesubnet, server.arg("forcesubnet").c_str(), LEN_IP);
    if (server.hasArg("forcegateway")) strlcpy(config.wifi.station.forcegateway, server.arg("forcegateway").c_str(), LEN_IP);
    if (server.hasArg("revertap"))  config.wifi.station.revertap = server.arg("revertap") == "true";
    wificfg_write(&config.wifi);
    flag_reboot = true;
    server.send(200, "application/json", json_ok());
  });
}

void api_initservice() {
  server.on("/api/service/get", HTTP_GET, [](){
    add_headers()
    check_auth()
    JsonObject& root = jsonbuf.createObject();
    root["hostname"] = config.service.hostname;
    root["security"] = config.service.security;
    root["http_enabled"] = config.service.http.enabled;
    root["mdns_enabled"] = config.service.mdns.enabled;
    root["auth_enabled"] = config.service.auth.enabled;
    root["auth_username"] = config.service.auth.username;
    root["auth_password"] = config.service.auth.password;
    root["lowcom_enabled"] = config.service.lowcom.enabled;
    root["lowcom_std_enabled"] = config.service.lowcom.std_enabled;
    root["lowcom_crypto_enabled"] = config.service.lowcom.crypto_enabled;
    root["mqtt_enabled"] = config.service.mqtt.enabled;
    root["mqtt_server"] = config.service.mqtt.server;
    root["mqtt_port"] = config.service.mqtt.port;
    root["mqtt_auth_enabled"] = config.service.mqtt.auth_enabled;
    root["mqtt_username"] = config.service.mqtt.username;
    root["mqtt_password"] = config.service.mqtt.password;
    root["mqtt_state_topic"] = config.service.mqtt.state_topic;
    root["mqtt_state_publish_period"] = config.service.mqtt.state_publish_period;
    root["mqtt_command_topic"] = config.service.mqtt.command_topic;
    root["ota_enabled"] = config.service.ota.enabled;
    root["ota_password"] = config.service.ota.password;
    root["status"] = "ok";
    JsonVariant v = root;
    server.send(200, "application/json", v.as<String>());
    jsonbuf.clear();
  });
  server.on("/api/service/set", HTTP_GET, [](){
    add_headers()
    check_auth()
    if (server.hasArg("hostname"))                strlcpy(config.service.hostname, server.arg("hostname").c_str(), LEN_HOSTNAME);
    if (server.hasArg("security"))                strlcpy(config.service.security, server.arg("security").c_str(), LEN_INFO);
    if (server.hasArg("http_enabled"))            config.service.http.enabled = server.arg("http_enabled") == "true";
    if (server.hasArg("mdns_enabled"))            config.service.mdns.enabled = server.arg("mdns_enabled") == "true";
    if (server.hasArg("auth_enabled"))            config.service.auth.enabled = server.arg("auth_enabled") == "true";
    if (server.hasArg("auth_username"))           strlcpy(config.service.auth.username, server.arg("auth_username").c_str(), LEN_USERNAME);
    if (server.hasArg("auth_password"))           strlcpy(config.service.auth.password, server.arg("auth_password").c_str(), LEN_PASSWORD);
    if (server.hasArg("lowcom_enabled"))          config.service.lowcom.enabled = server.arg("lowcom_enabled") == "true";
    if (server.hasArg("lowcom_std_enabled"))      config.service.lowcom.std_enabled = server.arg("lowcom_std_enabled") == "true";
    if (server.hasArg("lowcom_crypto_enabled"))   config.service.lowcom.crypto_enabled = server.arg("lowcom_crypto_enabled") == "true";
    if (server.hasArg("mqtt_enabled"))            config.service.mqtt.enabled = server.arg("mqtt_enabled") == "true";
    if (server.hasArg("mqtt_server"))             strlcpy(config.service.mqtt.server, server.arg("mqtt_server").c_str(), LEN_URL);
    if (server.hasArg("mqtt_port"))               config.service.mqtt.port = server.arg("mqtt_port").toInt();
    if (server.hasArg("mqtt_auth_enabled"))       config.service.mqtt.auth_enabled = server.arg("mqtt_auth_enabled") == "true";
    if (server.hasArg("mqtt_username"))           strlcpy(config.service.mqtt.username, server.arg("mqtt_username").c_str(), LEN_USERNAME);
    if (server.hasArg("mqtt_password"))           strlcpy(config.service.mqtt.password, server.arg("mqtt_password").c_str(), LEN_PASSWORD);
    if (server.hasArg("mqtt_state_topic"))        strlcpy(config.service.mqtt.state_topic, server.arg("mqtt_state_topic").c_str(), LEN_URL);
    if (server.hasArg("mqtt_state_publish_period")) config.service.mqtt.state_publish_period = server.arg("mqtt_state_publish_period").toFloat();
    if (server.hasArg("mqtt_command_topic"))      strlcpy(config.service.mqtt.command_topic, server.arg("mqtt_command_topic").c_str(), LEN_URL);
    if (server.hasArg("ota_enabled"))             config.service.ota.enabled = server.arg("ota_enabled") == "true";
    if (server.hasArg("ota_password"))            strlcpy(config.service.ota.password, server.arg("ota_password").c_str(), LEN_PASSWORD);
    servicecfg_write(&config.service);
    flag_reboot = true;
    server.send(200, "application/json", json_ok());
  });
  server.on("/api/service/state", HTTP_GET, [](){
    add_headers()
    check_auth()
    JsonObject& root = jsonbuf.createObject();
    root["lowcom_clients"] = state.service.lowcom.clients;
    root["mqtt_connected"] = state.service.mqtt.connected;
    root["status"] = "ok";
    JsonVariant v = root;
    server.send(200, "application/json", v.as<String>());
    jsonbuf.clear();
  });
  server.on("/api/service/streamprotocol", HTTP_GET, [](){
    add_headers()
    check_auth()
    JsonObject& root = jsonbuf.createObject();
    root["protocol"] = config.service.auth.enabled? "http" : "ws";
    root["status"] = "ok";
    JsonVariant v = root;
    server.send(200, "application/json", v.as<String>());
    jsonbuf.clear();
  });
  server.on("/api/service/security/set", HTTP_GET, [](){
    add_headers()
    check_auth()
    if (server.hasArg("security"))                strlcpy(config.service.security, server.arg("security").c_str(), LEN_INFO);
    servicecfg_write(&config.service);
    server.send(200, "application/json", json_ok());
  });
}

void api_initdaisy() {
  server.on("/api/daisy/get", HTTP_GET, [](){
    add_headers()
    check_auth()
    JsonObject& root = jsonbuf.createObject();
    root["enabled"] = config.daisy.enabled;
    root["master"] = config.daisy.master;
    if (config.daisy.master) {
      root["slaves"] = state.daisy.slaves;
    }
    root["slavewifioff"] = config.daisy.slavewifioff;
    root["status"] = "ok";
    JsonVariant v = root;
    server.send(200, "application/json", v.as<String>());
    jsonbuf.clear();
  });
  server.on("/api/daisy/set", HTTP_GET, [](){
    add_headers()
    check_auth()
    if (server.hasArg("enabled"))       config.daisy.enabled = server.arg("enabled") == "true";
    if (server.hasArg("master"))        config.daisy.master = server.arg("master") == "true";
    if (server.hasArg("slavewifioff"))  config.daisy.slavewifioff = server.arg("slavewifioff") == "true";
    daisycfg_write(&config.daisy);
    flag_reboot = true;
    server.send(200, "application/json", json_ok());
  });
  server.on("/api/daisy/wificontrol", HTTP_GET, [](){
    add_headers()
    check_auth()
    if (!config.daisy.enabled || !config.daisy.master || !state.daisy.active) {
      server.send(200, "application/json", json_error("daisy not active"));
      return;
    }
    if (!server.hasArg("enabled")) {
      server.send(200, "application/json", json_error("enabled arg must be specified"));
      return;
    }
    bool enabled = server.arg("enabled") == "true";
    for (uint8_t i = 1; i < state.daisy.slaves; i++) {
      daisy_wificontrol(i, nextid(), enabled);
    }
    server.send(200, "application/json", json_ok());
  });
}

void api_initcpu() {
  server.on("/api/cpu/adc", HTTP_GET, [](){
    add_headers()
    check_auth()
    JsonObject& root = jsonbuf.createObject();
    root["value"] = (double)analogRead(A0) * WIFI_ADCCOEFF;
    root["status"] = "ok";
    JsonVariant v = root;
    server.send(200, "application/json", v.as<String>());
    jsonbuf.clear();
  });
}

void api_initmotor() {
  server.on("/api/motor/get", HTTP_GET, [](){
    add_headers()
    check_auth()
    get_target()
    motor_config * cfg = target == 0? &config.motor : &sketch.daisy.slave[target - 1].config.motor;
    JsonObject& root = jsonbuf.createObject();
    if (server.hasArg("target")) root["target"] = target;
    root["mode"] = json_serialize(cfg->mode);
    root["stepsize"] = json_serialize(cfg->stepsize);
    root["ocd"] = cfg->ocd;
    root["ocdshutdown"] = cfg->ocdshutdown;
    root["maxspeed"] = cfg->maxspeed;
    root["minspeed"] = cfg->minspeed;
    root["accel"] = cfg->accel;
    root["decel"] = cfg->decel;
    root["fsspeed"] = cfg->fsspeed;
    root["fsboost"] = cfg->fsboost;
    root["cm_kthold"] = cfg->cm.kthold;
    root["cm_ktrun"] = cfg->cm.ktrun;
    root["cm_ktaccel"] = cfg->cm.ktaccel;
    root["cm_ktdecel"] = cfg->cm.ktdecel;
    root["cm_switchperiod"] = cfg->cm.switchperiod;
    root["cm_predict"] = cfg->cm.predict;
    root["cm_minon"] = cfg->cm.minon;
    root["cm_minoff"] = cfg->cm.minoff;
    root["cm_fastoff"] = cfg->cm.fastoff;
    root["cm_faststep"] = cfg->cm.faststep;
    root["vm_kthold"] = cfg->vm.kthold;
    root["vm_ktrun"] = cfg->vm.ktrun;
    root["vm_ktaccel"] = cfg->vm.ktaccel;
    root["vm_ktdecel"] = cfg->vm.ktdecel;
    root["vm_pwmfreq"] = cfg->vm.pwmfreq;
    root["vm_stall"] = cfg->vm.stall;
    root["vm_volt_comp"] = cfg->vm.volt_comp;
    root["vm_bemf_slopel"] = cfg->vm.bemf_slopel;
    root["vm_bemf_speedco"] = cfg->vm.bemf_speedco;
    root["vm_bemf_slopehacc"] = cfg->vm.bemf_slopehacc;
    root["vm_bemf_slopehdec"] = cfg->vm.bemf_slopehdec;
    root["reverse"] = cfg->reverse;
    root["status"] = "ok";
    JsonVariant v = root;
    server.send(200, "application/json", v.as<String>());
    jsonbuf.clear();
  });
  server.on("/api/motor/set", HTTP_GET, [](){
    add_headers()
    check_auth()
    get_target()
    get_queue()
    JsonObject& root = jsonbuf.createObject();
    if (server.hasArg("mode"))      root["mode"] = server.arg("mode");
    if (server.hasArg("stepsize"))  root["stepsize"] = server.arg("stepsize").toInt();
    if (server.hasArg("ocd"))       root["ocd"] = server.arg("ocd").toFloat();
    if (server.hasArg("ocdshutdown")) root["ocdshutdown"] = server.arg("ocdshutdown") == "true";
    if (server.hasArg("maxspeed"))  root["maxspeed"] = server.arg("maxspeed").toFloat();
    if (server.hasArg("minspeed"))  root["minspeed"] = server.arg("minspeed").toFloat();
    if (server.hasArg("accel"))     root["accel"] = server.arg("accel").toFloat();
    if (server.hasArg("decel"))     root["decel"] = server.arg("decel").toFloat();
    if (server.hasArg("fsspeed"))   root["fsspeed"] = server.arg("fsspeed").toFloat();
    if (server.hasArg("fsboost"))   root["fsboost"] = server.arg("fsboost") == "true";
    if (server.hasArg("cm_kthold")) root["cm_kthold"] = server.arg("cm_kthold").toFloat();
    if (server.hasArg("cm_ktrun"))  root["cm_ktrun"] = server.arg("cm_ktrun").toFloat();
    if (server.hasArg("cm_ktaccel")) root["cm_ktaccel"] = server.arg("cm_ktaccel").toFloat();
    if (server.hasArg("cm_ktdecel")) root["cm_ktdecel"] = server.arg("cm_ktdecel").toFloat();
    if (server.hasArg("cm_switchperiod")) root["cm_switchperiod"] = server.arg("cm_switchperiod").toFloat();
    if (server.hasArg("cm_predict")) root["cm_predict"] = server.arg("cm_predict") == "true";
    if (server.hasArg("cm_minon"))  root["cm_minon"] = server.arg("cm_minon").toFloat();
    if (server.hasArg("cm_minoff")) root["cm_minoff"] = server.arg("cm_minoff").toFloat();
    if (server.hasArg("cm_fastoff")) root["cm_fastoff"] = server.arg("cm_fastoff").toFloat();
    if (server.hasArg("cm_faststep")) root["cm_faststep"] = server.arg("cm_faststep").toFloat();
    if (server.hasArg("vm_kthold")) root["vm_kthold"] = server.arg("vm_kthold").toFloat();
    if (server.hasArg("vm_ktrun"))  root["vm_ktrun"] = server.arg("vm_ktrun").toFloat();
    if (server.hasArg("vm_ktaccel")) root["vm_ktaccel"] = server.arg("vm_ktaccel").toFloat();
    if (server.hasArg("vm_ktdecel")) root["vm_ktdecel"] = server.arg("vm_ktdecel").toFloat();
    if (server.hasArg("vm_pwmfreq")) root["vm_pwmfreq"] = server.arg("vm_pwmfreq").toFloat();
    if (server.hasArg("vm_stall"))  root["vm_stall"] = server.arg("vm_stall").toFloat();
    if (server.hasArg("vm_volt_comp")) root["vm_volt_comp"] = server.arg("vm_volt_comp") == "true";
    if (server.hasArg("vm_bemf_slopel")) root["vm_bemf_slopel"] = server.arg("vm_bemf_slopel").toFloat();
    if (server.hasArg("vm_bemf_speedco")) root["vm_bemf_speedco"] = server.arg("vm_bemf_speedco").toFloat();
    if (server.hasArg("vm_bemf_slopehacc")) root["vm_bemf_slopehacc"] = server.arg("vm_bemf_slopehacc").toFloat();
    if (server.hasArg("vm_bemf_slopehdec")) root["vm_bemf_slopehdec"] = server.arg("vm_bemf_slopehdec").toFloat();
    if (server.hasArg("reverse"))   root["reverse"] = server.arg("reverse") == "true";
    if (server.hasArg("save"))      root["save"] = server.arg("save") == "true";
    JsonVariant v = root;
    id_t id = nextid();
    m_setconfig(target, queue, id, v.as<String>().c_str());
    jsonbuf.clear();
    server.send(200, "application/json", json_okid(id));
  });
  server.on("/api/motor/state", HTTP_GET, [](){
    add_headers()
    check_auth()
    get_target()
    motor_state * st = target == 0? &state.motor : &sketch.daisy.slave[target - 1].state.motor;
    signal_state * sig = target == 0? &state.signal : &sketch.daisy.slave[target - 1].state.signal;
    command_state * cmd = target == 0? &state.command : &sketch.daisy.slave[target - 1].state.command;
    JsonObject& root = jsonbuf.createObject();
    if (server.hasArg("target")) root["target"] = target;
    root["stepss"] = st->stepss;
    root["pos"] = st->pos;
    root["mark"] = st->mark;
    root["vin"] = st->vin;
    root["dir"] = json_serialize(st->status.direction);
    root["movement"] = json_serialize(st->status.movement);
    root["hiz"] = st->status.hiz;
    root["busy"] = st->status.busy;
    root["switch"] = st->status.user_switch;
    root["stepclock"] = st->status.step_clock;
    JsonObject& alarms = root.createNestedObject("alarms");
    alarms["commanderror"] = st->status.alarms.command_error;
    alarms["overcurrent"] = st->status.alarms.overcurrent;
    alarms["undervoltage"] = st->status.alarms.undervoltage;
    alarms["thermalshutdown"] = st->status.alarms.thermal_shutdown;
    alarms["thermalwarning"] = st->status.alarms.thermal_warning;
    alarms["stalldetect"] = st->status.alarms.stall_detect;
    alarms["switch"] = st->status.alarms.user_switch;
    JsonObject& signal = root.createNestedObject("signal");
    signal["value"] = sig->value;
    signal["modified"] = sig->modified;
    JsonObject& command = root.createNestedObject("command");
    command["thisid"] = cmd->this_command;
    command["lastid"] = cmd->last_command;
    command["completed"] = cmd->last_completed;
    root["now"] = millis();   // TODO - offset timestamp if slave!
    root["status"] = "ok";
    JsonVariant v = root;
    server.send(200, "application/json", v.as<String>());
    jsonbuf.clear();
  });
  server.on("/api/motor/resetpos", HTTP_GET, [](){
    add_headers()
    check_auth()
    get_target()
    get_queue()
    id_t id = nextid();
    m_resetpos(target, queue, id);
    server.send(200, "application/json", json_okid(id));
  });
  server.on("/api/motor/setpos", HTTP_GET, [](){
    add_headers()
    check_auth()
    get_target()
    get_queue()
    if (!server.hasArg("pos")) {
      server.send(200, "application/json", json_error("pos arg must be specified"));
      return;
    }
    int pos = server.arg("pos").toInt();
    id_t id = nextid();
    m_setpos(target, queue, id, pos);
    server.send(200, "application/json", json_okid(id));
  });
  server.on("/api/motor/setmark", HTTP_GET, [](){
    add_headers()
    check_auth()
    get_target()
    get_queue()
    if (!server.hasArg("pos")) {
      server.send(200, "application/json", json_error("pos arg must be specified"));
      return;
    }
    int mark = server.arg("pos").toInt();
    id_t id = nextid();
    m_setmark(target, queue, id, mark);
    server.send(200, "application/json", json_okid(id));
  });
  server.on("/api/motor/run", HTTP_GET, [](){
    add_headers()
    check_auth()
    get_target()
    get_queue()
    if (!server.hasArg("stepss") || !server.hasArg("dir")) {
      server.send(200, "application/json", json_error("stepss, dir args must be specified."));
      return;
    }
    ps_direction dir = parse_direction(server.arg("dir"), FWD);
    float stepss = server.arg("stepss").toFloat();
    id_t id = nextid();
    m_run(target, queue, id, dir, stepss);
    server.send(200, "application/json", json_okid(id));
  });
  server.on("/api/motor/gohome", HTTP_GET, [](){
    add_headers()
    check_auth()
    get_target()
    get_queue()
    id_t id = nextid();
    m_gohome(target, queue, id);
    server.send(200, "application/json", json_okid(id));
  });
  server.on("/api/motor/gomark", HTTP_GET, [](){
    add_headers()
    check_auth()
    get_target()
    get_queue()
    id_t id = nextid();
    m_gomark(target, queue, id);
    server.send(200, "application/json", json_okid(id));
  });
  server.on("/api/motor/goto", HTTP_GET, [](){
    add_headers()
    check_auth()
    get_target()
    get_queue()
    if (!server.hasArg("pos")) {
      server.send(200, "application/json", json_error("position arg must be specified"));
      return;
    }
    id_t id = nextid();
    int pos = server.arg("pos").toInt();
    ps_direction dir = parse_direction(server.arg("dir"), FWD);
    m_goto(target, queue, id, pos, server.hasArg("dir"), dir);

    if (server.hasArg("stopswitch")) {
      bool state = server.arg("stopswitch") == "closed";
      id = nextid();
      m_stopswitch(target, queue, id, state);
    }
    
    server.send(200, "application/json", json_okid(id));
  });
  server.on("/api/motor/gountil", HTTP_GET, [](){
    add_headers()
    check_auth()
    get_target()
    get_queue()
    if (!server.hasArg("action") || !server.hasArg("dir") || !server.hasArg("stepss")) {
      server.send(200, "application/json", json_error("action, dir, stepss arg must be specified"));
      return;
    }
    ps_posact action = parse_action(server.arg("action"), POS_RESET);
    ps_direction dir = parse_direction(server.arg("dir"), FWD);
    float stepss = server.arg("stepss").toFloat();
    id_t id = nextid();
    m_gountil(target, queue, id, action, dir, stepss);
    server.send(200, "application/json", json_okid(id));
  });
  server.on("/api/motor/move", HTTP_GET, [](){
    add_headers()
    check_auth()
    get_target()
    get_queue()
    if (!server.hasArg("dir") || !server.hasArg("microsteps")) {
      server.send(200, "application/json", json_error("dir, microsteps arg must be specified"));
      return;
    }
    ps_direction dir = parse_direction(server.arg("dir"), FWD);
    int microsteps = server.arg("microsteps").toInt();
    if (microsteps <= 0) {
      server.send(200, "application/json", json_error("microsteps arg must be positive"));
      return;
    }
    id_t id = nextid();
    m_move(target, queue, id, dir, microsteps);
    server.send(200, "application/json", json_okid(id));
  });
  server.on("/api/motor/releasesw", HTTP_GET, [](){
    add_headers()
    check_auth()
    get_target()
    get_queue()
    if (!server.hasArg("action") || !server.hasArg("dir")) {
      server.send(200, "application/json", json_error("action, dir arg must be specified"));
      return;
    }
    ps_posact action = parse_action(server.arg("action"), POS_RESET);
    ps_direction dir = parse_direction(server.arg("dir"), FWD);
    id_t id = nextid();
    m_releasesw(target, queue, id, action, dir);
    server.send(200, "application/json", json_okid(id));
  });
  server.on("/api/motor/stepclock", HTTP_GET, [](){
    add_headers()
    check_auth()
    get_target()
    get_queue()
    if (!server.hasArg("dir")) {
      server.send(200, "application/json", json_error("dir arg must be specified"));
      return;
    }
    ps_direction dir = parse_direction(server.arg("dir"), FWD);
    id_t id = nextid();
    m_stepclock(target, queue, id, dir);
    server.send(200, "application/json", json_okid(id));
  });
  server.on("/api/motor/stop", HTTP_GET, [](){
    add_headers()
    check_auth()
    get_target()
    get_queue()
    bool hiz = server.hasArg("hiz") && server.arg("hiz") == "true";
    bool soft = server.hasArg("soft") && server.arg("soft") == "true";
    id_t id = nextid();
    m_stop(target, queue, id, hiz, soft);
    server.send(200, "application/json", json_okid(id));
  });
  server.on("/api/motor/waitbusy", HTTP_GET, [](){
    add_headers()
    check_auth()
    get_target()
    get_queue()
    id_t id = nextid();
    m_waitbusy(target, queue, id);
    server.send(200, "application/json", json_okid(id));
  });
  server.on("/api/motor/waitrunning", HTTP_GET, [](){
    add_headers()
    check_auth()
    get_target()
    get_queue()
    id_t id = nextid();
    m_waitrunning(target, queue, id);
    server.send(200, "application/json", json_okid(id));
  });
  server.on("/api/motor/waitms", HTTP_GET, [](){
    add_headers()
    check_auth()
    get_target()
    get_queue()
    if (!server.hasArg("ms")) {
      server.send(200, "application/json", json_error("millis arg must be specified"));
      return;
    }
    int ms = server.arg("ms").toInt();
    if (ms < 0) {
      server.send(200, "application/json", json_error("millis arg must be positive"));
      return;
    }
    id_t id = nextid();
    m_waitms(target, queue, id, ms);
    server.send(200, "application/json", json_okid(id));
  });
  server.on("/api/motor/waitswitch", HTTP_GET, [](){
    add_headers()
    check_auth()
    get_target()
    get_queue()
    bool state = server.hasArg("state") && server.arg("state") == "closed";
    id_t id = nextid();
    m_waitswitch(target, queue, id, state);
    server.send(200, "application/json", json_okid(id));
  });
  server.on("/api/motor/setsignal", HTTP_GET, [](){
    add_headers()
    check_auth()
    get_target()
    get_queue()
    if (!server.hasArg("value")) {
      server.send(200, "application/json", json_error("value arg must be specified"));
      return;
    }
    int value = server.arg("value").toInt();
    id_t id = nextid();
    m_setsignal(target, queue, id, value);
    server.send(200, "application/json", json_okid(id));
  });
  server.on("/api/motor/incsignal", HTTP_GET, [](){
    add_headers()
    check_auth()
    get_target()
    get_queue()
    int value = 1;
    if (server.hasArg("value")) {
      value = server.arg("value").toInt();
    }
    id_t id = nextid();
    m_incsignal(target, queue, id, value);
    server.send(200, "application/json", json_okid(id));
  });
  server.on("/api/queue/get", HTTP_GET, [](){
    add_headers()
    check_auth()
    get_queue()
    if (server.hasArg("target")) {
      server.send(200, "application/json", json_error("invalid argument. target must not be set."));
      return;
    }
    JsonObject& root = jsonbuf.createObject();
    JsonArray& arr = root.createNestedArray("queue");
    cmdq_write(arr, queue_get(queue));
    root["status"] = "ok";
    JsonVariant v = root;
    server.send(200, "application/json", v.as<String>());
    jsonbuf.clear();
  });
  server.on("/api/queue/add", HTTP_POST, [](){
    add_headers()
    check_auth()
    JsonArray& arr = jsonbuf.parseArray(server.arg("plain"));
    cmdq_read(arr);
    jsonbuf.clear();
    server.send(200, "application/json", json_okid(nextid()));
  });
  server.on("/api/motor/runqueue", HTTP_GET, [](){
    add_headers()
    check_auth()
    get_target()
    get_queue()
    if (!server.hasArg("targetqueue")) {
      server.send(200, "application/json", json_error("targetqueue arg must be specified"));
      return;
    }
    int targetqueue = server.arg("targetqueue").toInt();
    id_t id = nextid();
    m_runqueue(target, queue, id, targetqueue);
    server.send(200, "application/json", json_okid(id));
  });
  server.on("/api/motor/triggerqueue", HTTP_GET, [](){
    add_headers()
    check_auth()
    if (!server.hasArg("queue")) {
      server.send(200, "application/json", json_error("queue arg must be specified"));
      return;
    }
    if (!server.hasArg("target")) {
      server.send(200, "application/json", json_error("target arg must be specified"));
      return;
    }
    if (!server.hasArg("targetqueue")) {
      server.send(200, "application/json", json_error("targetqueue arg must be specified"));
      return;
    }
    int queue = server.arg("queue").toInt();
    int target = server.arg("target").toInt();
    int targetqueue = server.arg("targetqueue").toInt();
    id_t id = nextid();
    cmd_trigqueue(queue_get(queue), id, target, targetqueue);
    //server.send(200, "application/json", String("{\"status\":\"ok\",\"id\":") + id + ",\"queue\":" + queue + ",\"target\":" + target + ",\"targetqueue\":" + targetqueue + "}");
    server.send(200, "application/json", json_okid(id));
  });
  server.on("/api/queue/empty", HTTP_GET, [](){
    add_headers()
    check_auth()
    get_target()
    get_queue()
    id_t id = nextid();
    m_emptyqueue(target, queue, id);
    server.send(200, "application/json", json_okid(id));
  });
  server.on("/api/queue/save", HTTP_GET, [](){
    add_headers()
    check_auth()
    get_target()
    get_queue()
    if (queue == 0) {
      server.send(200, "application/json", json_error("cannot save queue 0"));
      return;
    }
    id_t id = nextid();
    m_savequeue(target, queue, id);
    server.send(200, "application/json", json_okid(id));
  });
  server.on("/api/queue/load", HTTP_GET, [](){
    add_headers()
    check_auth()
    get_target()
    get_queue()
    if (queue == 0) {
      server.send(200, "application/json", json_error("cannot load queue 0"));
      return;
    }
    id_t id = nextid();
    m_loadqueue(target, queue, id);
    server.send(200, "application/json", json_okid(id));
  });
  server.on("/api/queue/copy", HTTP_GET, [](){
    add_headers()
    check_auth()
    get_target()
    get_queue()
    if (!server.hasArg("sourcequeue")) {
      server.send(200, "application/json", json_error("sourcequeue arg must be specified"));
      return;
    }
    int sourcequeue = server.arg("sourcequeue").toInt();
    id_t id = nextid();
    m_copyqueue(target, queue, id, sourcequeue);
    server.send(200, "application/json", json_okid(id));
  });
  server.on("/api/motor/estop", HTTP_GET, [](){
    add_headers()
    check_auth()
    get_target()
    bool hiz = server.hasArg("hiz") && server.arg("hiz") == "true";
    bool soft = server.hasArg("soft") && server.arg("soft") == "true";
    id_t id = nextid();
    m_estop(target, id, hiz, soft);
    server.send(200, "application/json", json_okid(id));
  });
}

void api_init() {
  api_initwifi();
  api_initservice();
  api_initdaisy();
  api_initcpu();
  api_initmotor();
  
  server.on("/api/ping", HTTP_GET, [](){
    add_headers()
    check_auth()
    JsonObject& obj = jsonbuf.createObject();
    obj["status"] = "ok";
    obj["data"] = "pong";
    JsonVariant v = obj;
    server.send(200, "application/json", v.as<String>());
    jsonbuf.clear();
  });
  server.on("/api/error/get", HTTP_GET, [](){
    add_headers()
    check_auth()
    JsonObject& obj = jsonbuf.createObject();
    obj["errored"] = state.error.errored;
    obj["now"] = millis();
    if (state.error.errored) {
      obj["when"] = state.error.when;
      obj["subsystem"] = state.error.subsystem;
      obj["id"] = state.error.id;
      obj["type"] = state.error.type;
      obj["arg"] = state.error.arg;
    }
    obj["status"] = "ok";
    JsonVariant v = obj;
    server.send(200, "application/json", v.as<String>());
    jsonbuf.clear();
  });
  server.on("/api/error/clear", HTTP_GET, [](){
    add_headers()
    check_auth()
    // Clear local errors
    cmd_clearerror();
    clearerror();

    // Clear daisy errors
    if (config.daisy.enabled && config.daisy.master && state.daisy.active) {
      for (uint8_t i = 1; i <= state.daisy.slaves; i++) {
        daisy_clearerror(i, nextid());
      }
    }
    server.send(200, "application/json", json_okid(nextid()));
  });
  server.on("/api/crypto/get", HTTP_GET, [](){
    add_headers()
    check_auth()
    JsonObject& obj = jsonbuf.createObject();
    obj["fault"] = state.service.crypto.fault;
    obj["probed"] = state.service.crypto.probed;
    obj["available"] = !state.service.crypto.fault && state.service.crypto.available;
    obj["provisioned"] = state.service.crypto.provisioned;
    obj["status"] = "ok";
    JsonVariant v = obj;
    server.send(200, "application/json", v.as<String>());
    jsonbuf.clear();
  });
  server.on("/api/crypto/set", HTTP_GET, [](){
    add_headers()
    check_auth()
    if (!server.hasArg("master") || !server.hasArg("key")) {
      server.send(200, "application/json", json_error("master, key args must be specified"));
      return;
    }
    if (state.service.crypto.fault || !ecc_ok()) {
      server.send(200, "application/json", json_error("Crypto not available"));
      return;
    }
    
    String master = server.arg("master");
    String key = server.arg("key");
    bool f = !ecc_locked()? ecc_provision(master.c_str(), key.c_str()) : ecc_setpassword(master.c_str(), key.c_str());
    if (!f) {
      server.send(200, "application/json", json_error("Could not set crypto configuration."));
      return;
    }

    // Loop waiting for crypto
    for (size_t i = 0; i < 500; i++) {
      yield();
      ESP.wdtFeed();
      ecc_loop(millis());
      delay(1);
    }

    // Send response
    if (sketch.service.crypto.mark != ECC_SUCCESS) {
      server.send(200, "application/json", json_error("Crypto configuration failed. (Check master key)"));
    } else {
      server.send(200, "application/json", json_ok());
      flag_reboot = true;
    }
  });
  server.on("/api/factoryreset", HTTP_GET, [](){
    add_headers()
    check_auth()
    resetcfg();
    flag_reboot = true;
    server.send(200, "application/json", json_ok());
  });
  server.on("/api/version", HTTP_GET, [](){
    add_headers()
    check_auth()
    JsonObject& obj = jsonbuf.createObject();
    obj["product"] = PRODUCT;
    obj["model"] = MODEL;
    obj["branch"] = BRANCH;
    obj["version"] = VERSION;
    obj["status"] = "ok";
    JsonVariant v = obj;
    server.send(200, "application/json", v.as<String>());
    jsonbuf.clear();
  });
}
