goodrobotics/wifistepper/firmware/mfg-wifistepper/hostprint.h

#ifndef __HOSTPRINT_H
#define __HOSTPRINT_H


void host_print(const char * str);
void host_print(const char * str1, const char * str2);
void host_print(const char * str1, size_t i);
void host_print(const char * str1, double d);

#endif
