goodrobotics/wifistepper/(commit log)

2019-07-09 Added hardware CAD, bugfixes, and documentation tweaks
    [powerstep01-breakout-B.Cu.gbr, powerstep01-breakout-B.Mask.gbr, powerstep01-breakout-B.Paste.gbr, powerstep01-breakout-B.SilkS.gbr, powerstep01-breakout-Edge.Cuts.gbr, powerstep01-breakout-F.Cu.gbr, powerstep01-breakout-F.Mask.gbr, powerstep01-breakout-F.Paste.gbr]
2021-05-19 Board design update with more firmware features
    [wifistepper-B.Cu.gbr, wifistepper-B.Mask.gbr, wifistepper-B.Paste.gbr, wifistepper-B.SilkS.gbr, wifistepper-B_Cu.gbr, wifistepper-B_Mask.gbr, wifistepper-B_Paste.gbr, wifistepper-B_SilkS.gbr]
